kantum/pop/PCB/POP_Altium/Sent to Gregoire/Bill of Materials/Bill_of_Materials.xls

Quantity | Designator | Comment | Footprint | Description | Fabricant | Fabricant_REF | Fournisseur | Fournisseur_REF | Price
1.0 | A1 | PHOTO_DIODE | TCRT5000 | Photo-diode | VISHAY | TCRT5000 | Farnell | 1470066 | 0.7
2.0 | C1, C2 | 22uF | CAPC1608X90N | 50V | MURATA | GRT31CR61E226KE01L | Farnell | 2672212 | 1,33
1.0 | C3 | 8.2nF | CAPC1608X90N | 25V | MURATA |  | Farnell
1.0 | C4 | 100nF | CAPC1608X90N | 10V | MURATA |  | Farnell
1.0 | C5 | 120pF | CAPC1608X90N | 50V | MURATA |  | Farnell
1.0 | C6 | 4.7nF | CAPC1608X90N | 25V | MURATA |  | Farnell
1.0 | C7 | 47uF | CAPMP7343X310N | GRM32ER60J476ME20L 3225 ! | KEMET | T491D476K025AT | Farnell | 1457517 | 1.9
1.0 | C8 | 2.20uF | CAPC1608X90N | 6.3V | MURATA |  | Farnell
1.0 | C9 | 1.20nF | CAPC1608X90N | 50V | MURATA |  | Farnell
1.0 | C10 | 4.70uF | CAPC1608X90N |  | MURATA |  | Farnell
4.0 | C11, C12, C17, C20 | 0.1uF | CAPC1608X90N | Ceramic, Ceramic, Ceramic, Capacitor | MURATA |  | Farnell
2.0 | C13, C14 | 4.7uF | CAPC1608X90N | Ceramic | MURATA |  | Farnell
2.0 | C15, C16 | 22pF | CAPC1608X90N | Capacitor | MURATA |  | Farnell
2.0 | C18, C19 | 10uF | CAPC1608X90N | Capacitor | MURATA |  | Farnell
1.0 | C21 | 4.7uF/25V tantal | CAPMP3216X180N | Capacitor | KEMET | T491D476K025AT | Farnell | 2283561 | 0.332
1.0 | C22 | 4.7uF | CAPC2012X135N | Capacitor | MURATA |  | Farnell
1.0 | C23 | 0.1uF | CAPC2012X135N | Capacitor | MURATA |  | Farnell
1.0 | C24 | 100uF | AVX-B_TANTALUM-SMD-100UF-6.3V(AVX-B)(Primary) | Polarized Capacitor (Axial) | AVX | TAJB107M006RNJ | Farnell | 1833917 | 0.914
1.0 | D1 | 550mV | SOD123 | Diode | ON SEMICONDUCTOR | SS24FL | Farnell | 2822566 | 0.297
1.0 | D2 | 0.500V | SOD123 | Diode | DIODES INC | B130LAW-7-F | Farnell | 1858617 | 0.302
4.0 | D3, D4, D5, D6 | RGB_LED_A | RGB_LED | RGB_LED Common Anode |  |  | Aliexpress |  | 0.004
1.0 | DS1 | OLED_Display_128x64 | HRS_FH12-24S-0.5SH(55) |  | MIDAS | MCOT128064H1V-WM | Farnell | 2817924 | 18.81
1.0 | J1 | ICSP | ICSP_HEADER | Header, 6-Pin | MOLEX | 53047-0610 | Farnell | 9733078 | 0.403
1.0 | J2 | DM3AT-SF-PEJM5 | HRS_DM3AT-SF-PEJM5_DM3AT-SF-PEJM5(Primary) | DM3 RA SMT microSD memory card push/push | HIROSE(HRS) | DM3AT-SF-PEJM5(40) | Farnell | 1764374 | 2.64
1.0 | L1 | 18uH | SD43 Inductor | Inductor | COILCRAFT | SD43-183MLB | Farnell | 2526954 | 0.921
1.0 | L2 | 22uH | ME3220 Inductor | Inductor | COILCRAFT | ME3220-223KLB | Farnell | 2287928 | 0.661
1.0 | LS1 | Buzzer | ABT-460-RC | Magnetic Transducer Buzzer | PRO SIGNAL | ABT-460-RC | Farnell | 2783902 | 1.55
1.0 | P1 | Header 2 | 2477 | Header, 2-Pin | KEYSTONE | 2477 | Farnell | 1650684 | 1.41
4.0 | Q1, Q3, Q4, Q5 | 2N7002 | SOT23-3 | N-Channel MOSFET | NEXPERIA | 2N7002BK | Farnell | 1859847 | 0.196
1.0 | Q2 | BS250F | SOT23-3 | P-Channel MOSFET | DIODES INC | BS250FTA | Farnell | 1843731 | 0.539
2.0 | Q6, Q7 | 27002 | SOT23-3 | N-Channel MOSFET | NEXPERIA | 2N7002BK | Farnell | 1859847 | 0.196
4.0 | R1, R4, R12, R22 | 10k | RESC1608X55N | Resistor | MULTICOMP, MULTICOMP, MULTICOMP, [NoValue] |  | Farnell, Farnell, Farnell, [NoValue]
1.0 | R2 | 1M | RESC1608X55N | Resistor | MULTICOMP |  | Farnell
1.0 | R3 | 15k | RESC1608X55N | Resistor | MULTICOMP |  | Farnell
1.0 | R5 | 3.3k | RESC1608X55N | Resistor | MULTICOMP |  | Farnell
1.0 | R6 | 51k | RESC1608X55N | Resistor | MULTICOMP |  | Farnell
1.0 | R7 | 14k | RESC1608X55N | Resistor | MULTICOMP | MCWR06X1402FTL | Farnell | 2447252 | 0.0036
1.0 | R8 | 130k | RESC1608X55N | Resistor | MULTICOMP |  | Farnell
17.0 | R9, R10, R11, R14, R15, R16, R17, R19, R21, R23, R24, R28, R29, R30, R31, R33, R34 | 50k | RESC1608X55N | Resistor | [NoValue], [NoValue], MULTICOMP, MULTICOMP, MULTICOMP, MULTICOMP, MULTICOMP, MULTICOMP, MULTICOMP, MULTICOMP, MULTICOMP, MULTICOMP, MULTICOMP, MULTICOMP, MULTICOMP, MULTICOMP, MULTICOMP |  | [NoValue], [NoValue], Farnell, Farnell, Farnell, Farnell, Farnell, Farnell, Farnell, Farnell, Farnell, Farnell, Farnell, Farnell, Farnell, Farnell, Farnell
2.0 | R13, R20 | 1k | RESC1608X55N | 1k, Resistor | MULTICOMP |  | Farnell
1.0 | R18 | 910k | RESC1608X55N | Resistor | MULTICOMP |  | Farnell
3.0 | R25, R26, R27 | 33R | RESC1608X55N | Resistor | MULTICOMP |  | Farnell
1.0 | R32 | 30R | RESC1608X55N | Resistor | MULTICOMP |  | Farnell
1.0 | Rot1 | EC11E15244C0 | EC11E15244C0 | Rotary Encoder | ALPS | EC11E15244C0 | Farnell | 1520806 | 3.32
1.0 | S1 | Reset | SWITCH_4x6 | Switch | FGHGF | 1158238 | Aliexpress | 32788506240 | 0.0211
1.0 | S2 | Flash | SWITCH_4x6 | Switch | FGHGF | 1158238 | Aliexpress | 32788506240 | 0.0211
1.0 | U1 | TPS54231 | SOIC-8 |  | TEXAS INSTRUMENTS | TPS54231DR | Farnell | 2854681 | 1.55
1.0 | U2 | LM27313DBV | SOT23-5 |  | TEXAS INSTRUMENTS | LM27313XMF/NOPB | Farnell | 1564771 | 1.27
1.0 | U3 | 74HC595 | SOIC-16 | Shift Register
1.0 | U4 | PIC32MX174F256B-I/SO | SOIC-28 | PIC32 | MICROCHIP | PIC32MX174F256B-I/SO | Farnell | 2775021 | 3,84
1.0 | U5 | ESP-12F | ESP_12_E |  | ESPRESSIF | ESP-12F | Aliexpress | 32858988324 | 1.6
1.0 | Y1 | Crystal | 9C | Crystal Oscillator | TXC | 9C-8.000MEEJ-T | Farnell | 1842347 | 0.604
