kantum/pop/PCB/POP_Altium/3D_STEP/TCRT5000.stp

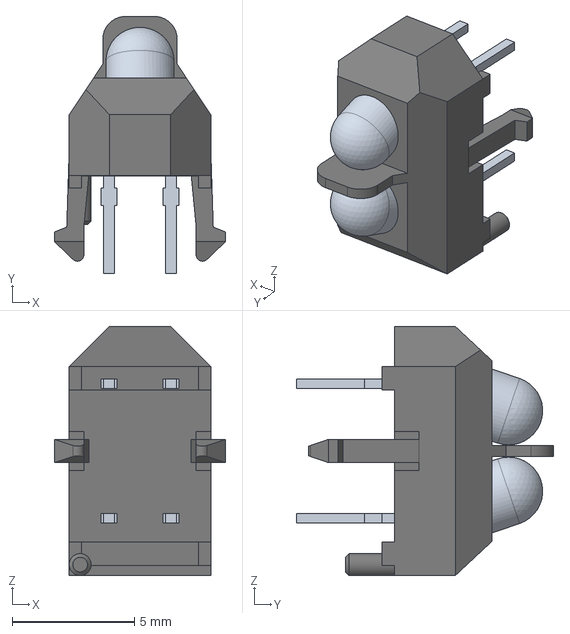
[picture p16: CAD file, 2018-06-24]
PCB/POP_Altium/3D_STEP/TCRT5000.stp
7.00 x 10.5 x 10.2 mm
LEDs
Metal Contacts
