kantum/pop/PCB/POP_Altium/3D_STEP/ABLS-8.000MHZ-B2-T.STEP

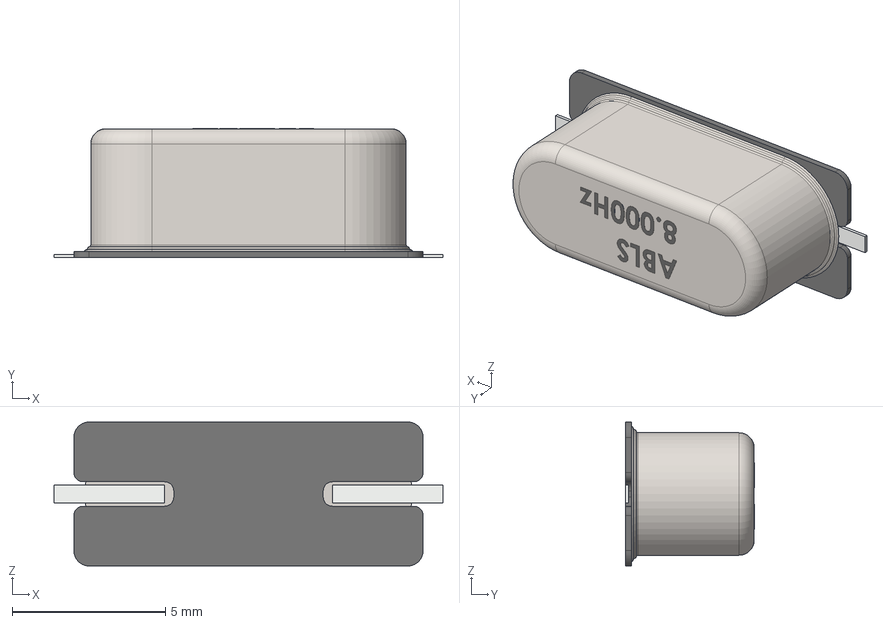
[picture p17: CAD file, 2018-06-24]
PCB/POP_Altium/3D_STEP/ABLS-8.000MHZ-B2-T.STEP
12.7 x 4.21 x 4.70 mm
