kantum/pop/PCB/POP_Altium/3D_STEP/SW_SPST_CK_RS282G05A3.step

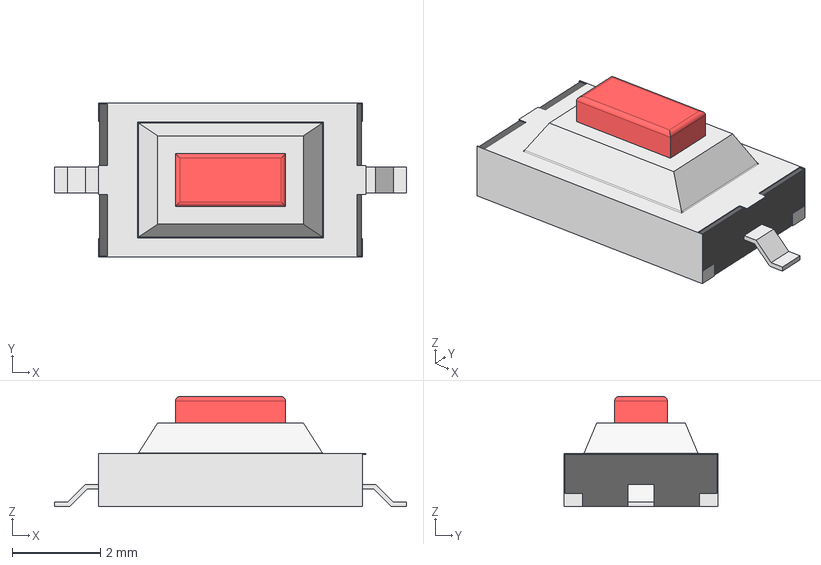
[picture p18: CAD file, 2018-06-24]
PCB/POP_Altium/3D_STEP/SW_SPST_CK_RS282G05A3.step
8.00 x 3.50 x 2.50 mm
