kantum/pop/PCB/POP_Altium/3D_STEP/sdr1005.stp

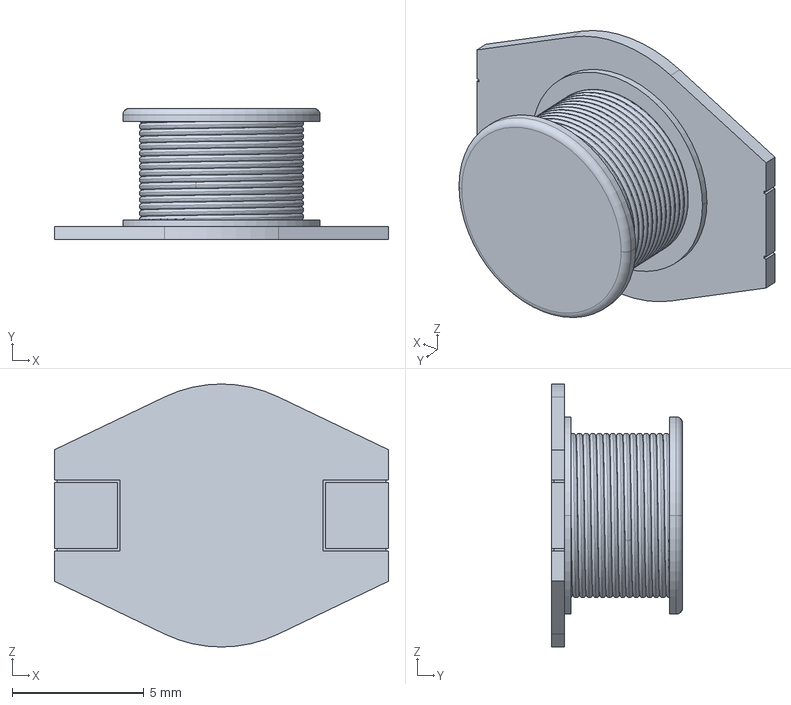
[picture p19: CAD file, 2018-06-24]
PCB/POP_Altium/3D_STEP/sdr1005.stp
12.7 x 5.00 x 10.0 mm
