kantum/pop/PCB/POP_Altium/3D_STEP/sdr2207.stp

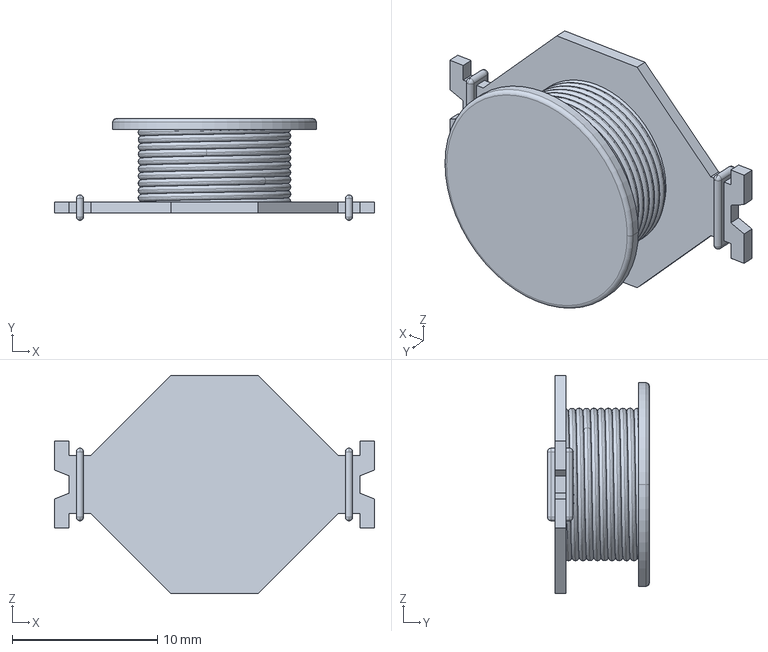
[picture p20: CAD file, 2018-06-24]
PCB/POP_Altium/3D_STEP/sdr2207.stp
22.0 x 7.00 x 15.0 mm
