kantum/pop/PCB/POP_Altium/3D_STEP/DM3AT-SF-PEJM5.stp

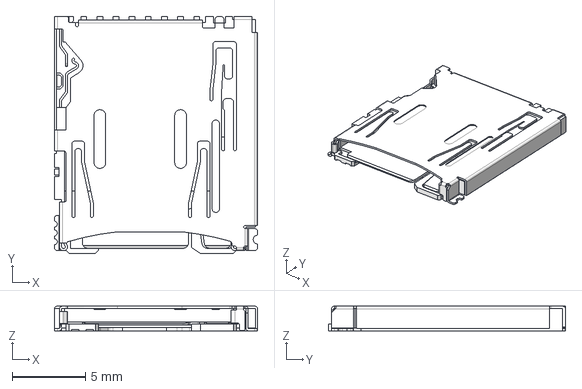
[picture p21: CAD file, 2018-06-24]
PCB/POP_Altium/3D_STEP/DM3AT-SF-PEJM5.stp
13.8 x 16.2 x 1.68 mm
