kantum/pop/PCB/POP_Altium/3D_STEP/soic_28.step

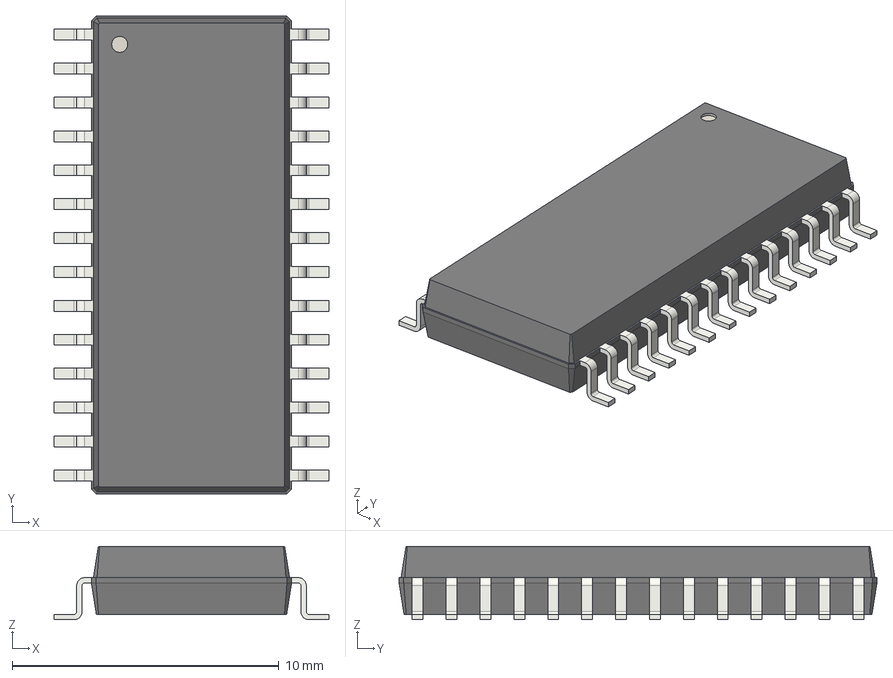
[picture p22: CAD file, 2018-06-24]
PCB/POP_Altium/3D_STEP/soic_28.step
10.3 x 17.9 x 2.75 mm
