kantum/pop/PCB/POP_Altium/3D_STEP/OPB732.STEP

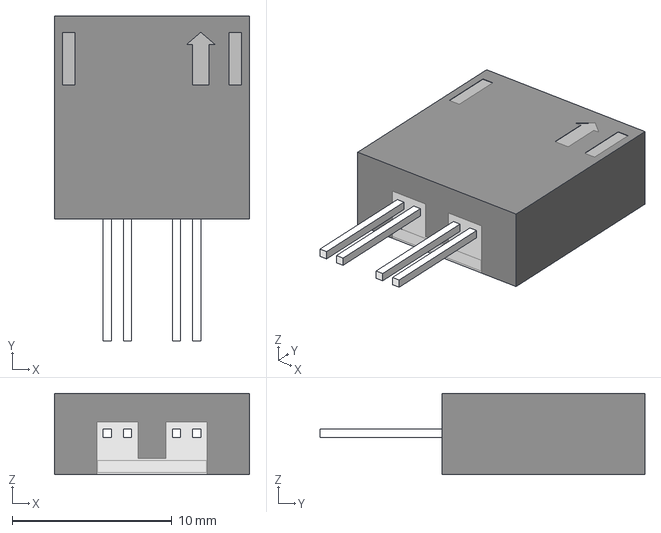
[picture p23: CAD file, 2018-06-24]
PCB/POP_Altium/3D_STEP/OPB732.STEP
12.2 x 20.3 x 5.08 mm
