kantum/pop/PCB/POP_Altium/3D_STEP/buzzer.step

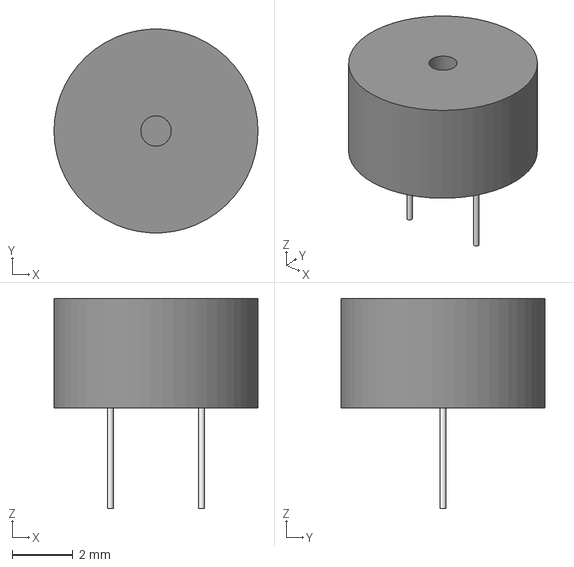
[picture p24: CAD file, 2018-06-24]
PCB/POP_Altium/3D_STEP/buzzer.step
6.70 x 6.69 x 6.90 mm
