kantum/pop/PCB/POP_Altium/3D_STEP/atwinc1500.step

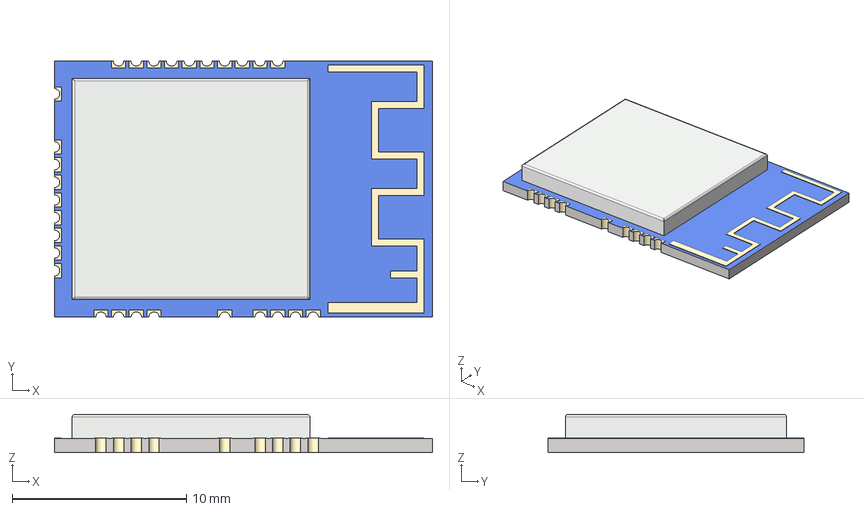
[picture p25: CAD file, 2018-06-24]
PCB/POP_Altium/3D_STEP/atwinc1500.step
21.7 x 14.7 x 2.20 mm
