kantum/pop/PCB/POP_Altium/3D_STEP/Led RGB 5mm.STEP

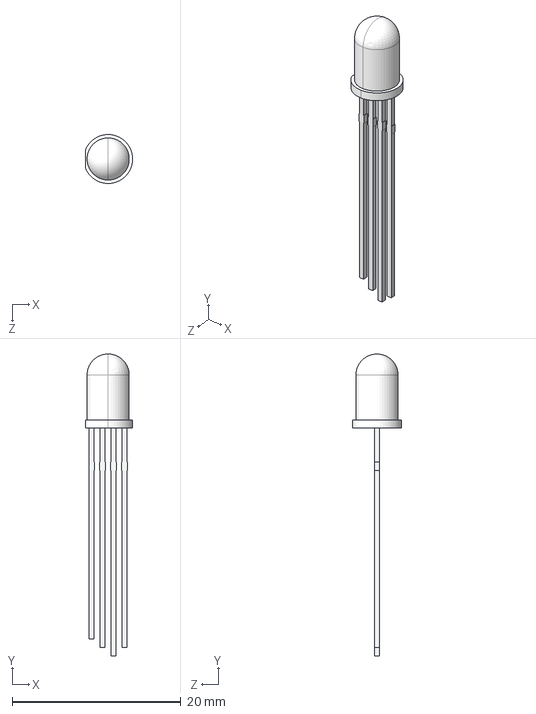
[picture p26: CAD file, 2018-06-24]
PCB/POP_Altium/3D_STEP/Led RGB 5mm.STEP
5.60 x 35.8 x 5.80 mm
Lente^Led RGB 5mm
Terminais^Led RGB 5mm
