kantum/pop/PCB/POP_Altium/3D_STEP/530470610.stp

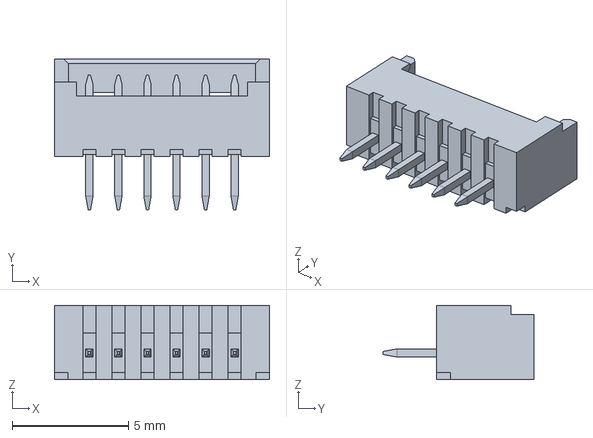
[picture p27: CAD file, 2018-06-24]
PCB/POP_Altium/3D_STEP/530470610.stp
9.25 x 6.50 x 3.20 mm
