kantum/pop/PCB/POP_Altium/Sent to Gregoire/Schematic Prints/Schematic_Prints.pdf

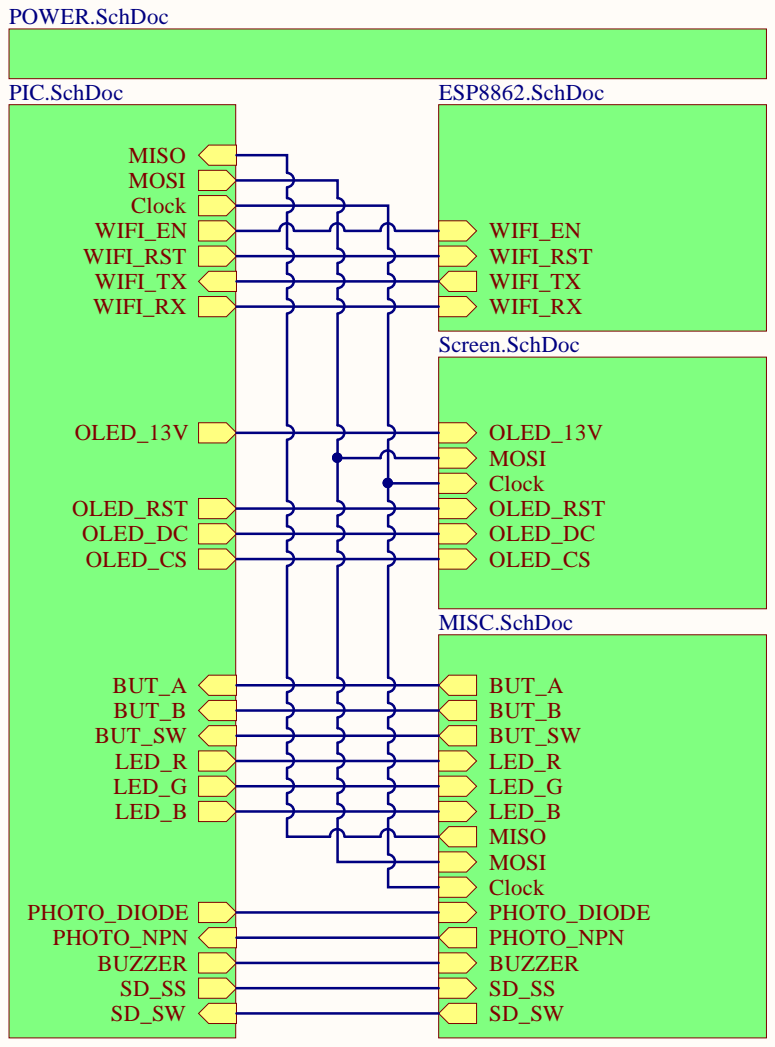
[picture p28: page 1]

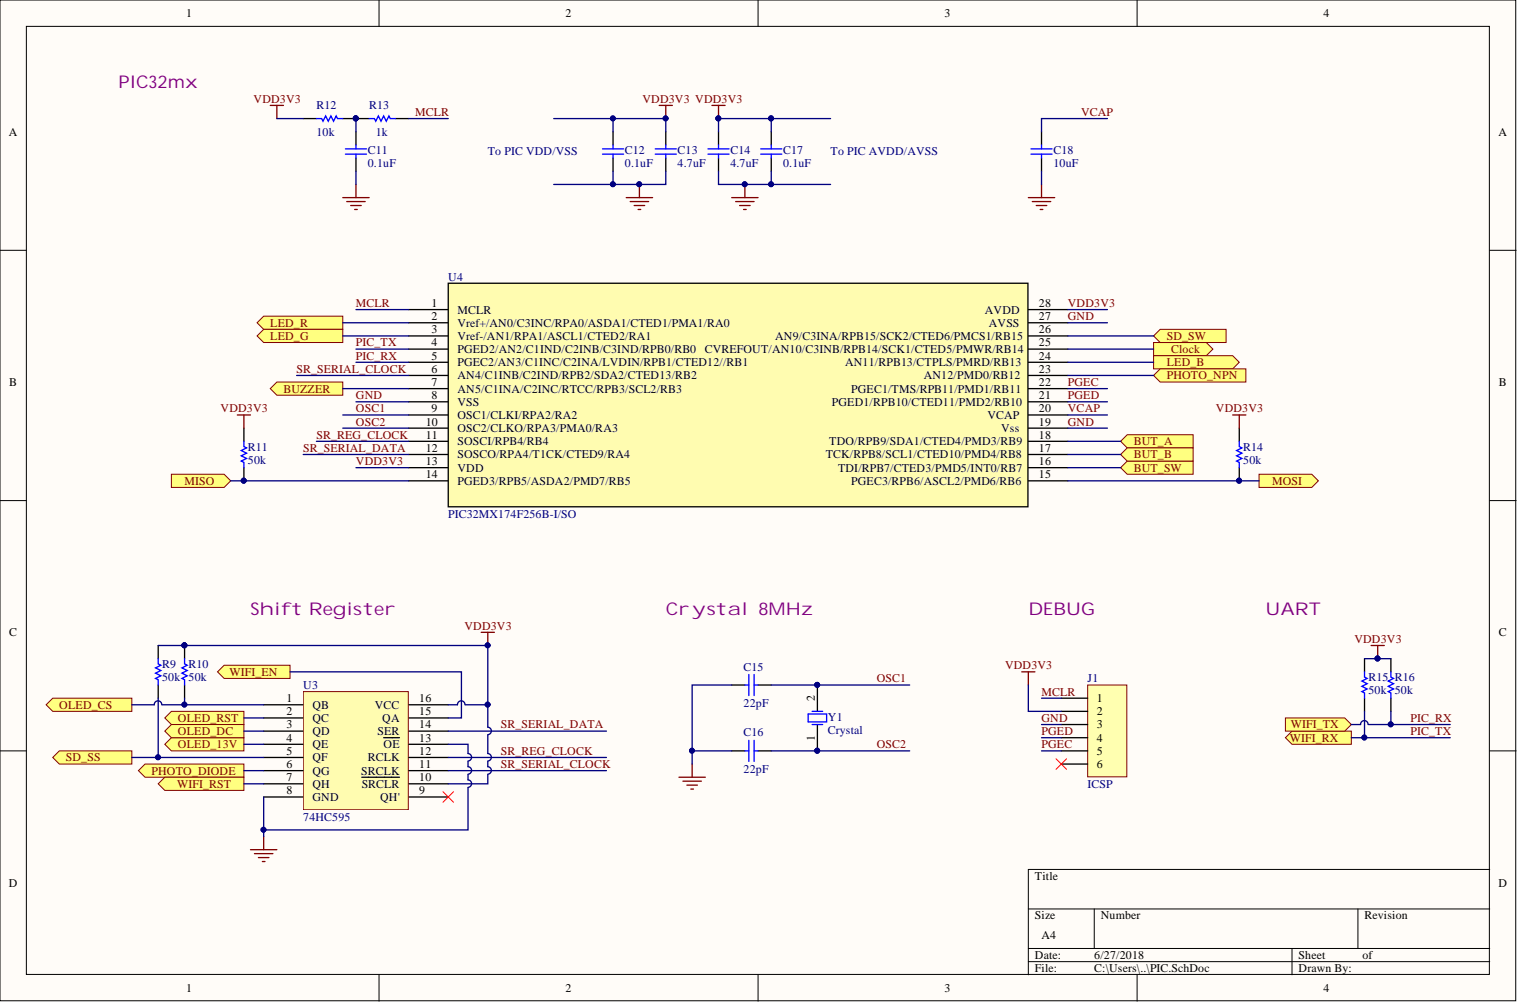
[picture p29: page 2]

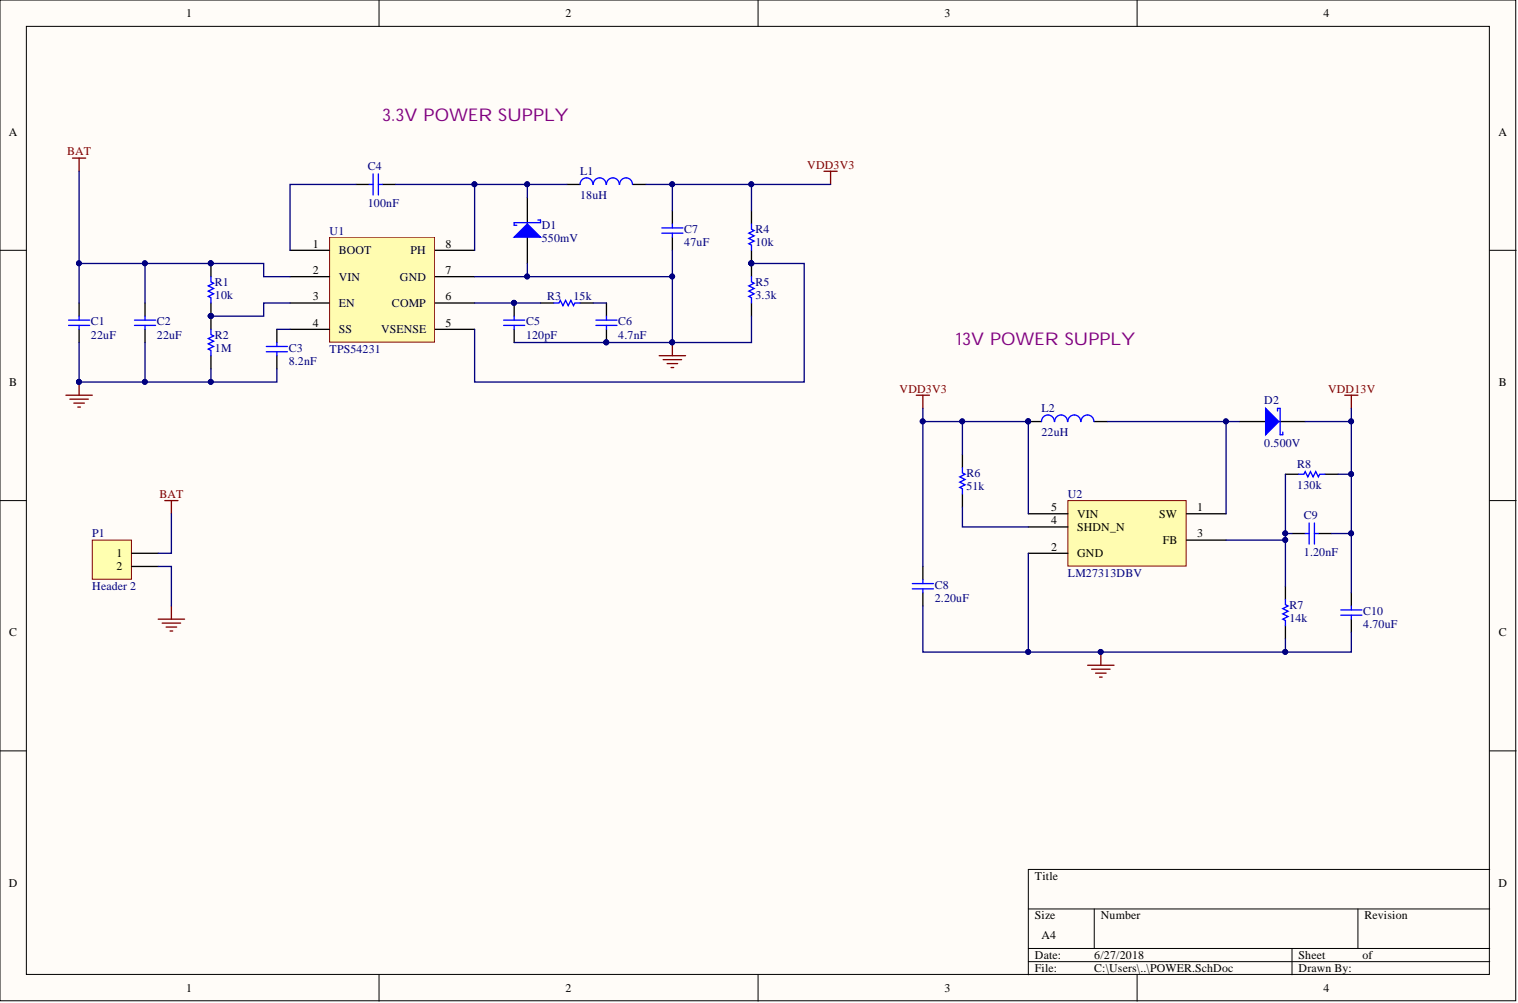
[picture p30: page 3]

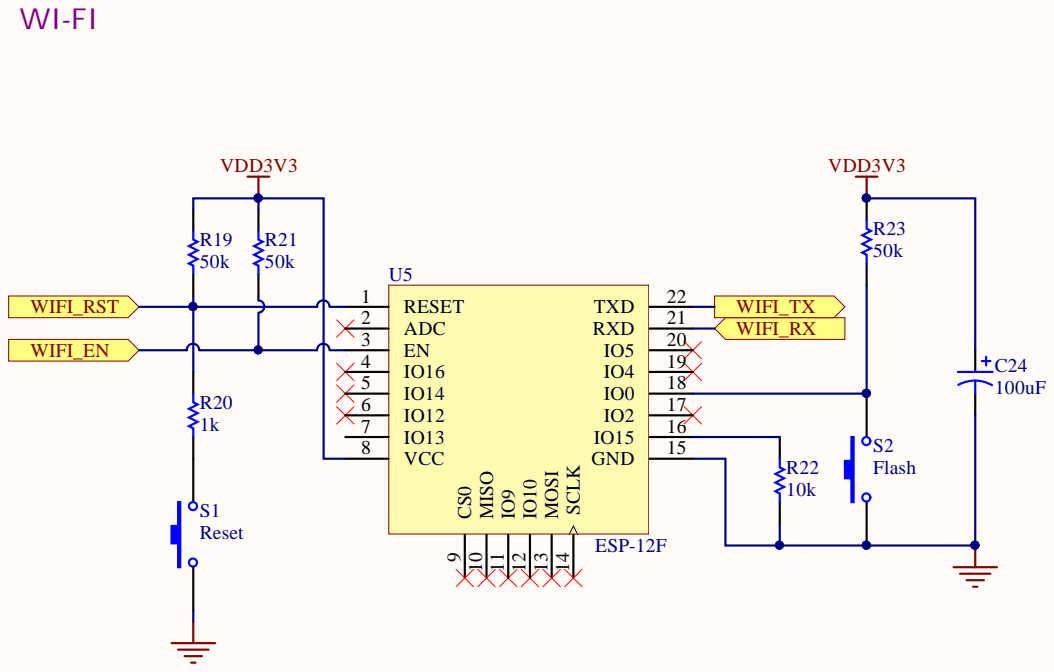
[picture p31: page 4]

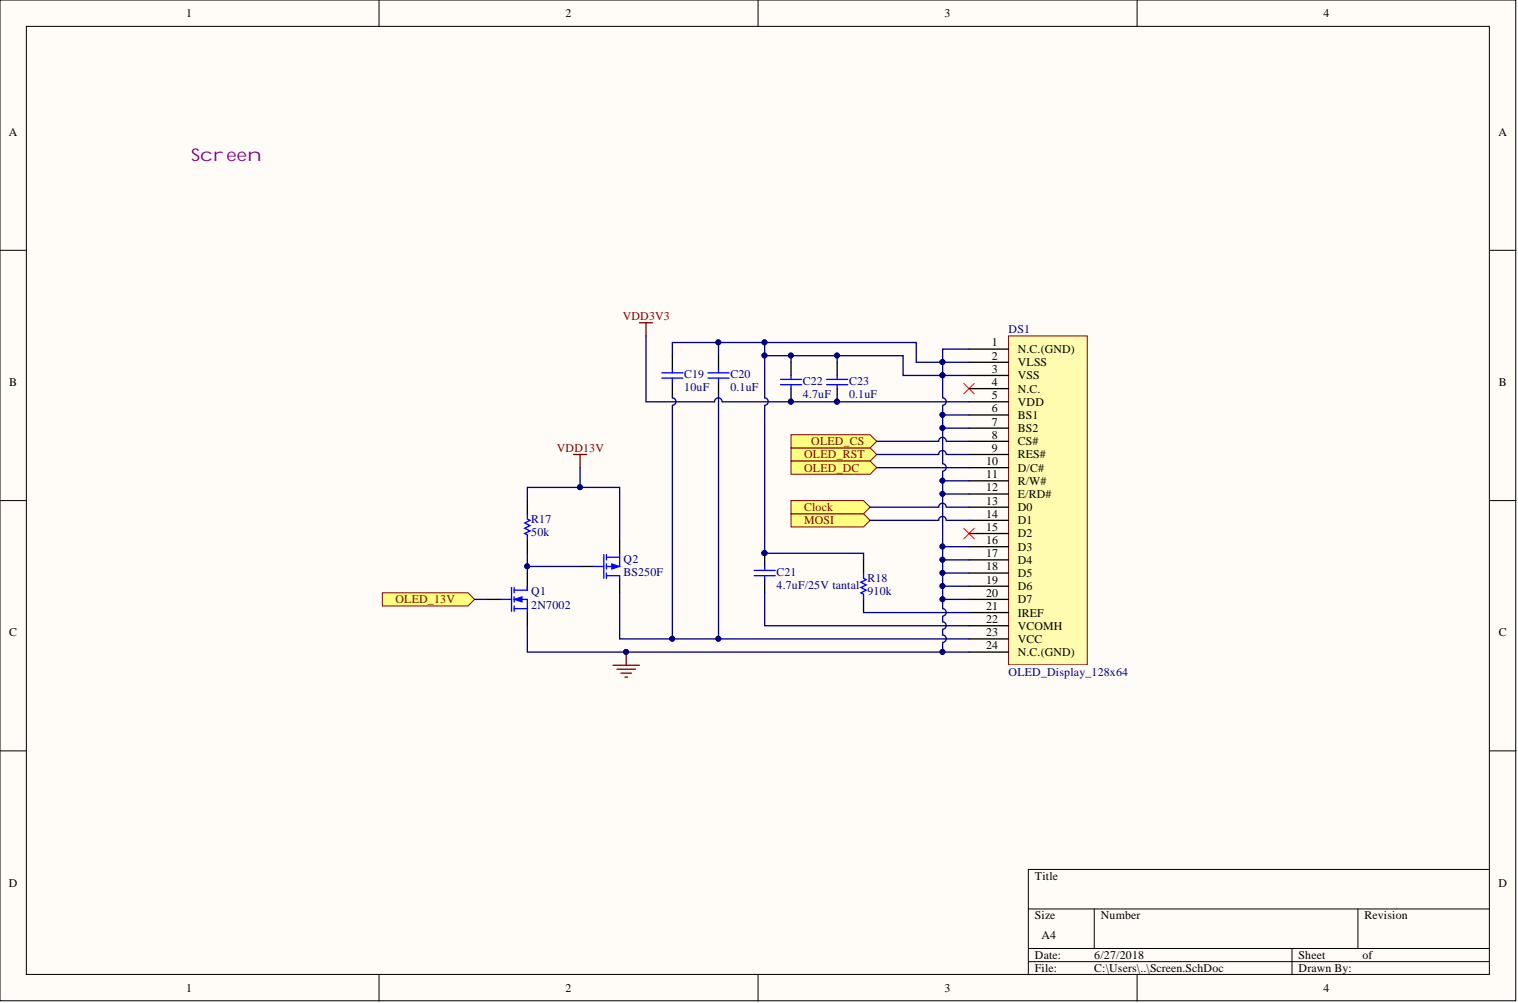
[picture p32: page 5]

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
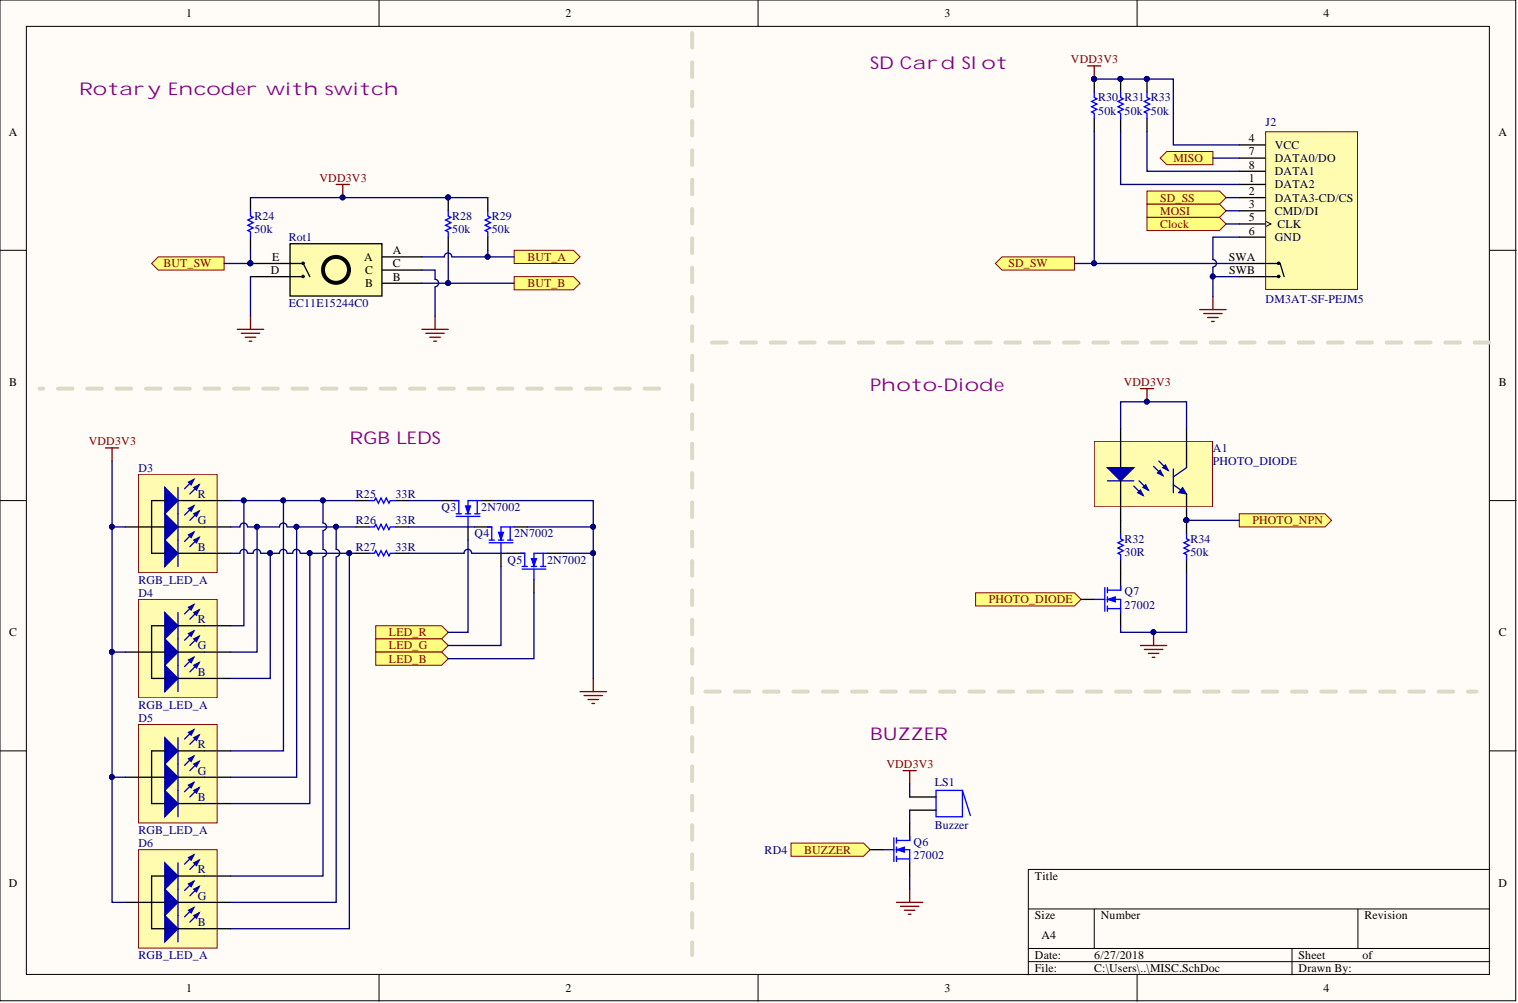
[picture p33: page 6]

Rotary Encoder with switch
