kantum/pop/PCB/POP_Altium/Sent to Gregoire/Assembly Drawing/Assembly_Drawings.PDF

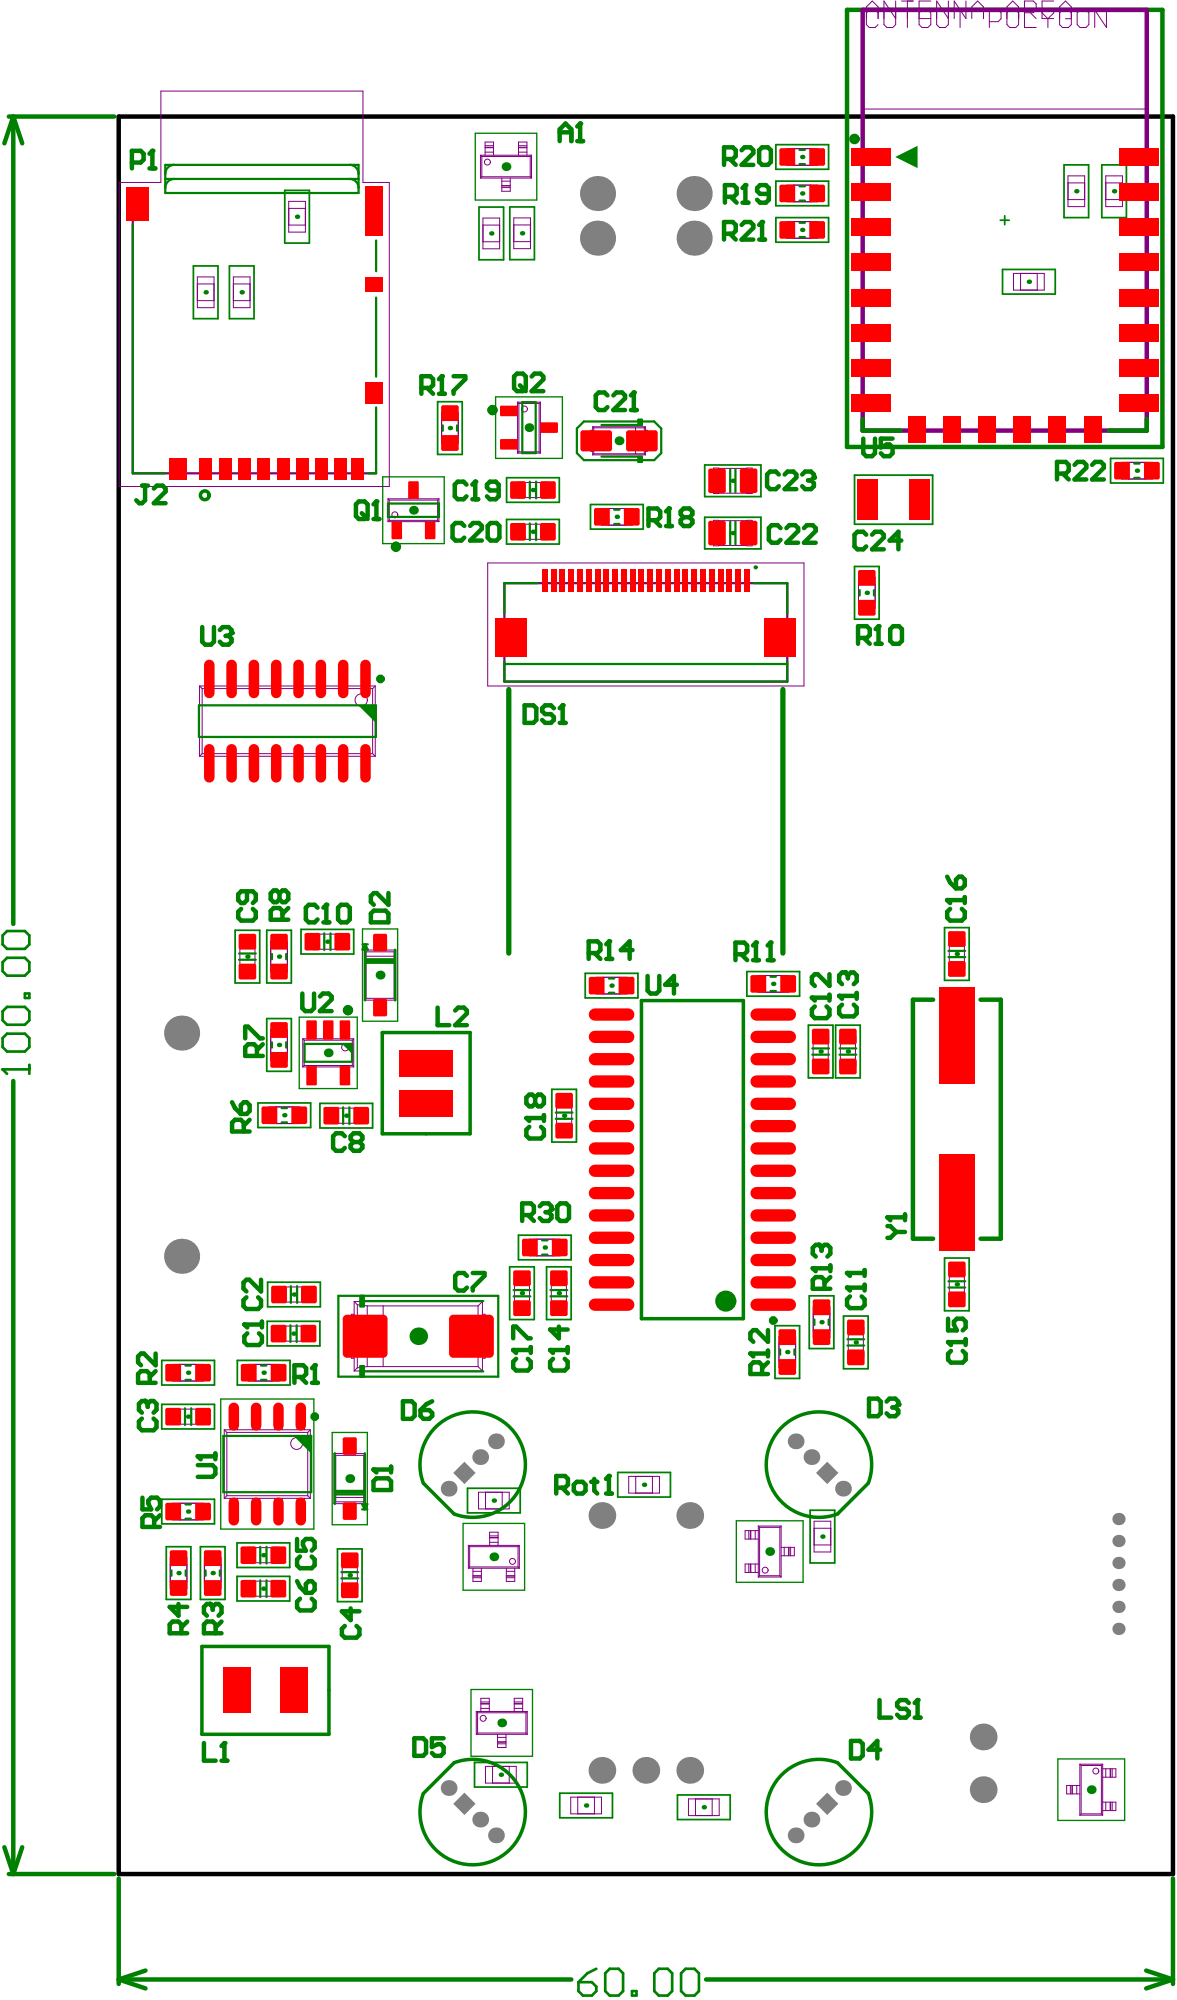
[picture p34: page 1]

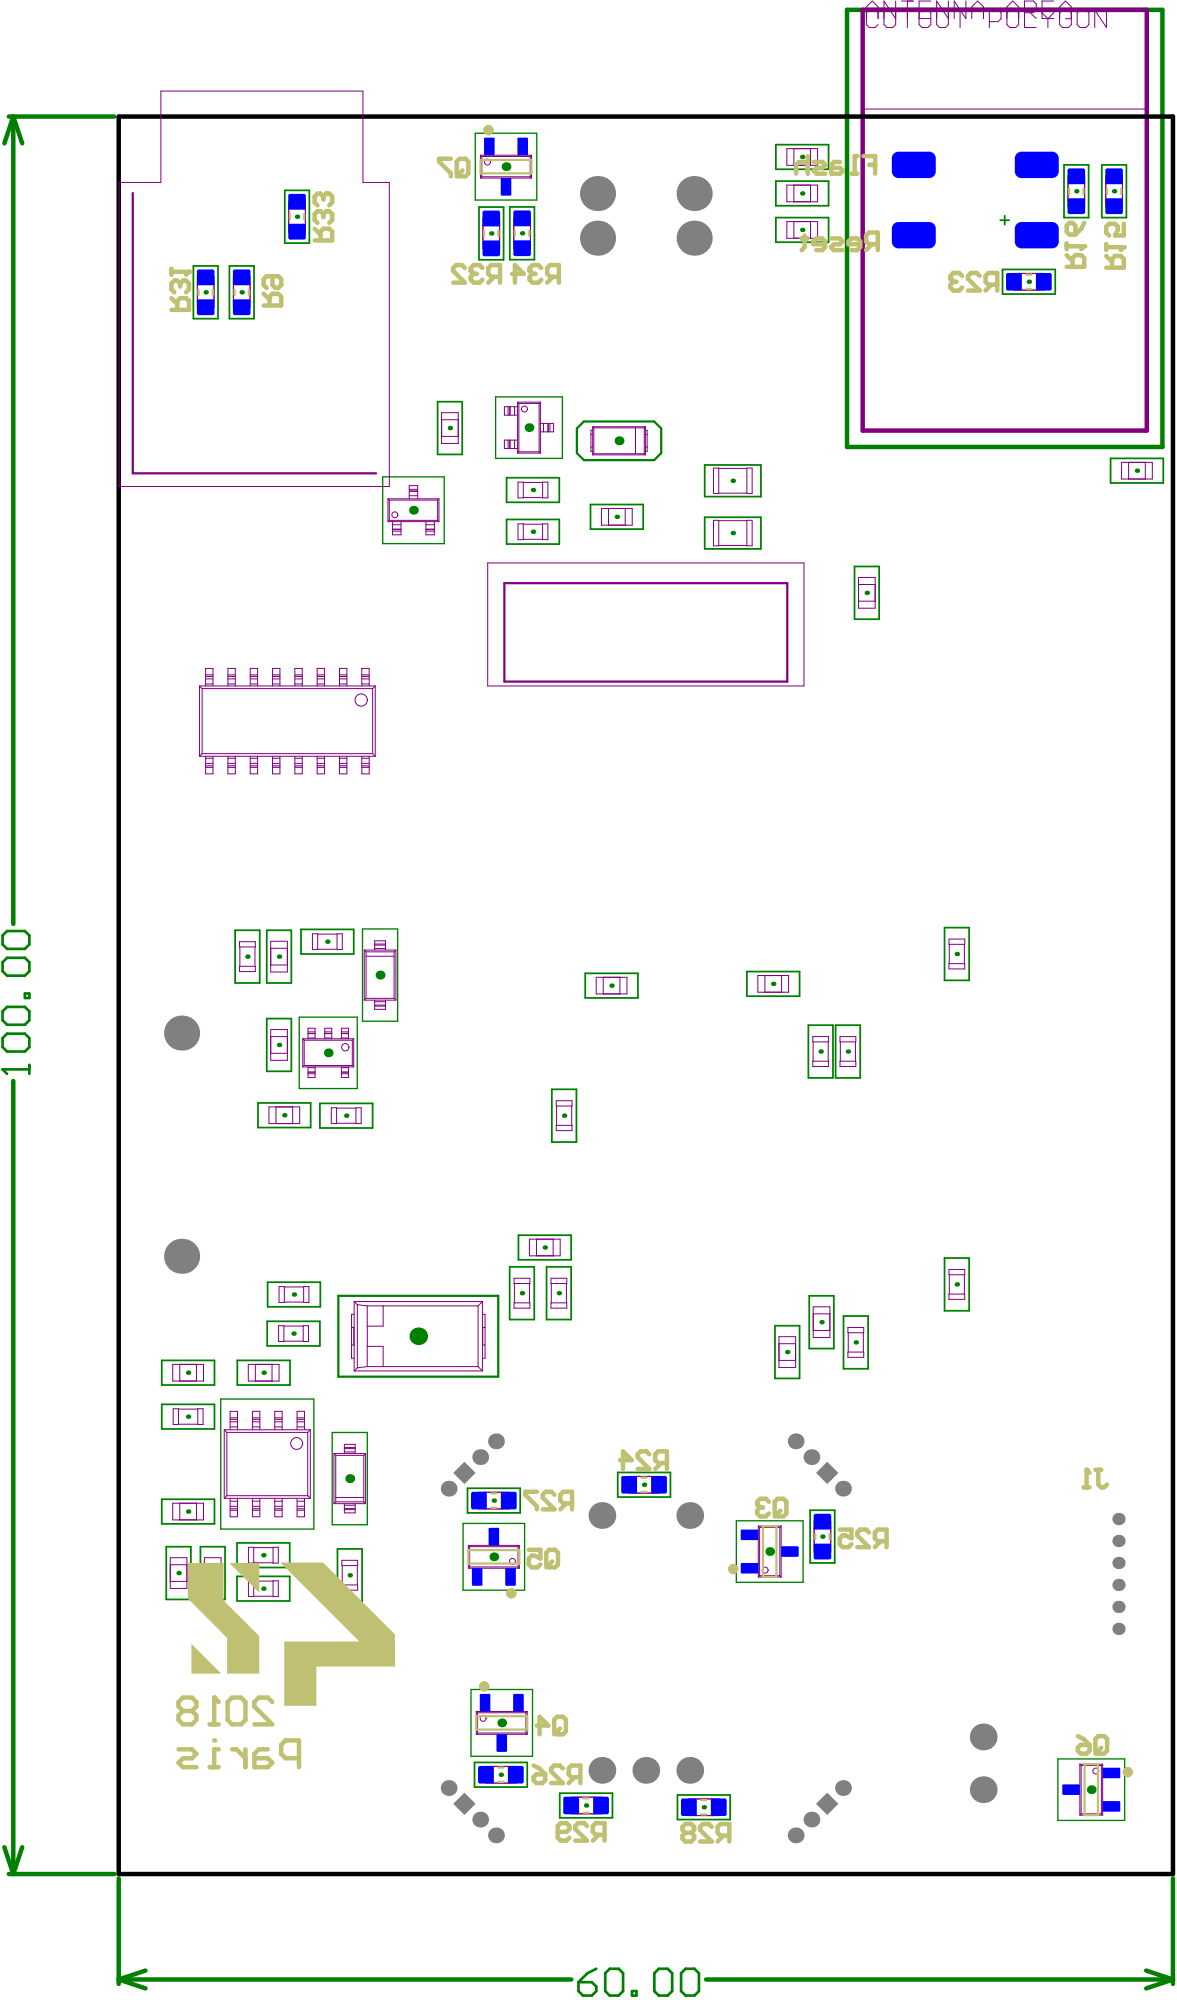
[picture p35: page 2]
