kantum/pop/PCB/POP_Altium/Sent to Gregoire/Mechanical Drawings/Mechanical_Drawings.PDF

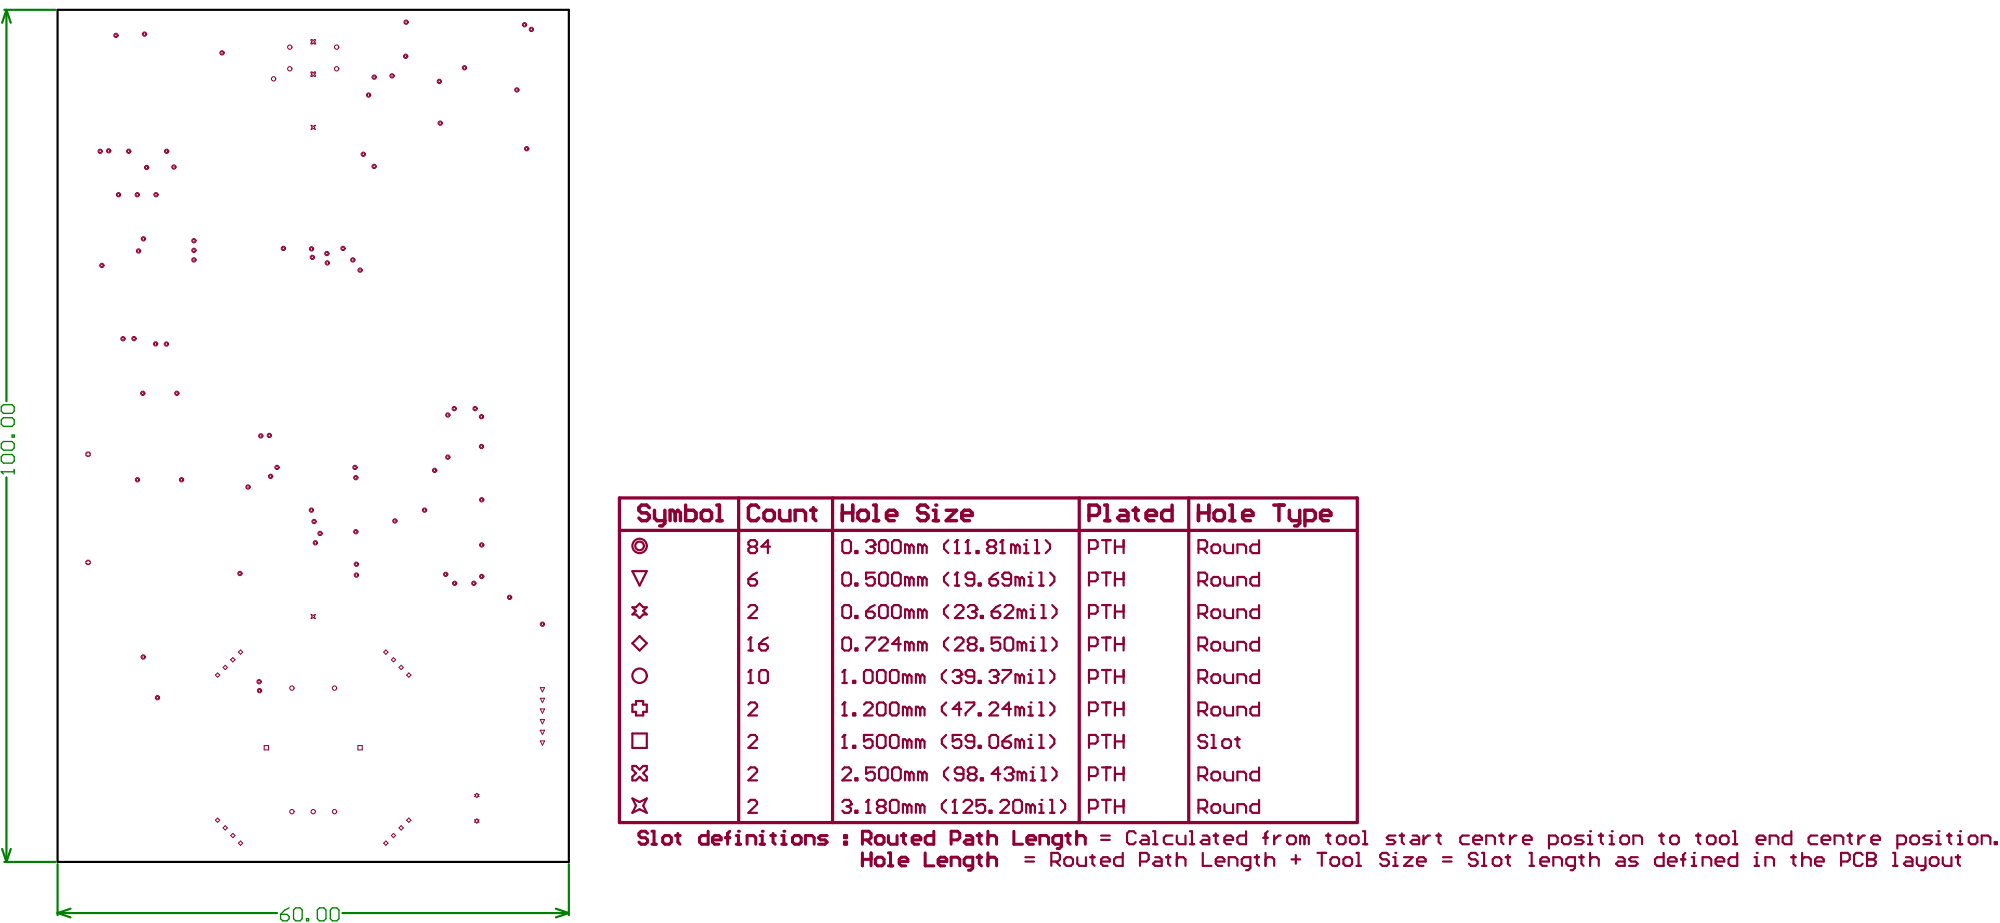
[picture p36: page 1]
