kantum/pop/(list of files, drawings)

Other design files:
PCB/POP_Altium/ESP8862.SchDoc
PCB/POP_Altium/MISC.SchDoc
PCB/POP_Altium/PIC.SchDoc
PCB/POP_Altium/PICMX340F512H.SchDoc
PCB/POP_Altium/POP.PrjPcb
PCB/POP_Altium/POP_lib.SchLib
PCB/POP_Altium/POWER.SchDoc
PCB/POP_Altium/Root.SchDoc
PCB/POP_Altium/Screen.SchDoc
