kantum/pop/Firmware/pop.X/screen.h

#ifndef SCREEN_H
#define	SCREEN_H

#define OLED_RES_TRIS TRISDbits.TRISD5
#define OLED_D_C_TRIS TRISDbits.TRISD6
#define OLED_VCC_TRIS TRISDbits.TRISD7
#define OLED_RES_LAT LATDbits.LATD5
#define OLED_D_C_LAT LATDbits.LATD6
#define OLED_VCC_LAT LATDbits.LATD7

#define COMMAND LOW
#define DATA	HIGH
#define OLED_SPI(x) SPI_queue_byte(x, 1)

#define	WHITE		0xFF
#define	BLACK		0x0
#define	CONTRAST	128


#define OLED_ELLIPSIS_CHAR      92 // 'z' + 2

#define OLED_FONT_NORMAL        0b00000000
#define OLED_FONT_DOUBLE        0b00000001
#define OLED_FONT_IS_HALF       0b00000010
#define OLED_FONT_TOP           0b00000100
#define OLED_FONT_INVERTED      0b00001000
#define OLED_FONT_TRANSPARENT   0b00010000


//0 > Font Regular/Double 
//0 > Is Halved
//0 > Halved Bottom Top
//0 > Normal/Inverted
//0 > Opaque/Transparent Background
//0 > 
//0 > 
//0 >

void	OLED_refresh(void);
void	OLED_fill(byte color);
void	OLED_wake(void);
void	OLED_run(void);
void	OLED_run(void);
void	OLED_putstr(byte *str, byte font, byte offset);
byte	OLED_extend_char(byte b, byte lvl);
void	OLED_set_contrast(byte contrast);

#define OLED_wifi_icon      14    
static const unsigned char OLED_wifi[] = {
    0x06, 0x02, 0x1B, 0x0D, 0x25, 0x35, 0x55, 0x35, 0x25, 0x0D, 0x1B, 0x02, 0x06, 0x00
};
static const unsigned char OLED_wifi_err[] = {
    0x06, 0x02, 0x1B, 0x0D, 0x05, 0x00, 0x5F, 0x00, 0x05, 0x0D, 0x1B, 0x02, 0x06, 0x00
};

static const unsigned char OLED_img1[] = {
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
	0x00, 0x00, 0x00, 0x00, 0x00, 0x00, 0x00, 0x00, 0x00, 0x00, 0x00, 0x00, 0x00, 0x00, 0x00, 0x00,
	0x00, 0x00, 0x00, 0x00, 0x00, 0x00, 0x00, 0x00, 0x00, 0x00, 0x00, 0x00, 0x00, 0x00, 0x00, 0x00,
	0x00, 0x00, 0x00, 0x00, 0x00, 0x00, 0x00, 0x00, 0x00, 0x00, 0x00, 0x00, 0x00, 0x00, 0x00, 0x00,
	0x00, 0x00, 0x00, 0x00, 0x00, 0x00, 0x00, 0x00, 0x00, 0x00, 0x00, 0x00, 0x00, 0x00, 0x00, 0x00,
	0x00, 0x00, 0x00, 0x00, 0x00, 0x00, 0x00, 0x00, 0x00, 0x00, 0x00, 0x00, 0x00, 0x00, 0x00, 0x00
};

#endif	/* SCREEN_H */
