kantum/pop/Firmware/POP2.X/settings.h

#ifndef SETTINGS_H
#define	SETTINGS_H

#define WIFI_PASS_LEN 20

//     | SETTING            | OFFST | LENGTH | 
#define SETTING_MODE              0 ,      1
#define SETTING_CONTRAST          1 ,      1
#define SETTING_SOUND             2 ,      1
#define SETTING_DISTANCE          3 ,      2
#define SETTING_PASSWORD          5 ,      4
#define SETTING_SECURITY          9 ,      1
#define SETTING_LANGUAGE		  10,      1

#include "types.h"

byte     settings_mode;
byte     settings_contrast;
byte     settings_sound;
uint16_t settings_distance;
uint32_t settings_password;
byte     settings_security;
byte     settings_language;

char	wifi_ssid[WIFI_PASS_LEN];
char	wifi_pass[WIFI_PASS_LEN];

bool	settings_get_wifi_credentials(void);
bool	settings_set_setting(size_t offset, size_t size, byte* val);
bool	settings_get_setting(size_t offset, size_t size, byte* val);
bool    settings_load(void);

#endif	/* SETTINGS_H */
