kantum/pop/Firmware/POP2.X/types.h

#ifndef TYPES_H
#define	TYPES_H

#include <xc.h>				// PIC32 Mandatory Include
#include <stdbool.h>		// Contains bool type
#include <stdint.h>			// Contains uint_8 uint_16...
#include <sys/attribs.h>	// Contains __ISR() Macros

typedef uint8_t byte;

#define OUTPUT  		0
#define INPUT   		1

#define HIGH    		1
#define LOW     		0

#define UP				1
#define DOWN			0

#define RISING_EDGE		1
#define FALLING_EDGE	0

//#define SYSCLOCK		48000000
#define SYSCLOCK		24000000
//#define SYSCLOCK		6000000

void	pps_init();

#endif	/* TYPES_H */
