kantum/pop/(commit log)

2018-06-24 added altium files
    [530470610.stp, ABLS-8.000MHZ-B2-T.STEP, DM3AT-SF-PEJM5.stp, ESP8862.SchDoc, Led RGB 5mm.STEP, MISC.SchDoc, OPB732.STEP, PIC.SchDoc]
2018-06-24 update schematics for inductors
    [ESP8862.SchDoc, MISC.SchDoc, PIC.SchDoc, POWER.SchDoc, Screen.SchDoc]
2018-06-27 Solved shift register output enable
    [Bill_of_Materials.xls, ESP8862.SchDoc, MISC.SchDoc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]
2018-06-29 changed mosfet_pnp for bs250f
2018-07-03 rotary encoder on his way...
2018-09-04 led rgb piezo not working
    [UI.c, delay.c, device.c, led.c, main.c, pages.c, photo.c, piezo.c]
2018-09-04 added sd dump
    [config.txt]
2018-09-04 Wi-Fi UART bug solved. Now we're able to use the Wi-Fi with the new PIC
    [UART.c, device.c, main.c, pages.c, settings.c, wheel.c, wifi.c]
2018-09-05 Solved UART Wi-Fi Scan problem
    [wifi.c]
2018-09-05 Done LED Feedback
2018-09-05 Added led_random function
